zhang-haitao-repo/HoloCubic_Test/Doc/NaivePCB及外壳资料/NaivePCB及外壳资料/主板/主板v2.0（换卡槽版）/主板v2.0渲染图.png

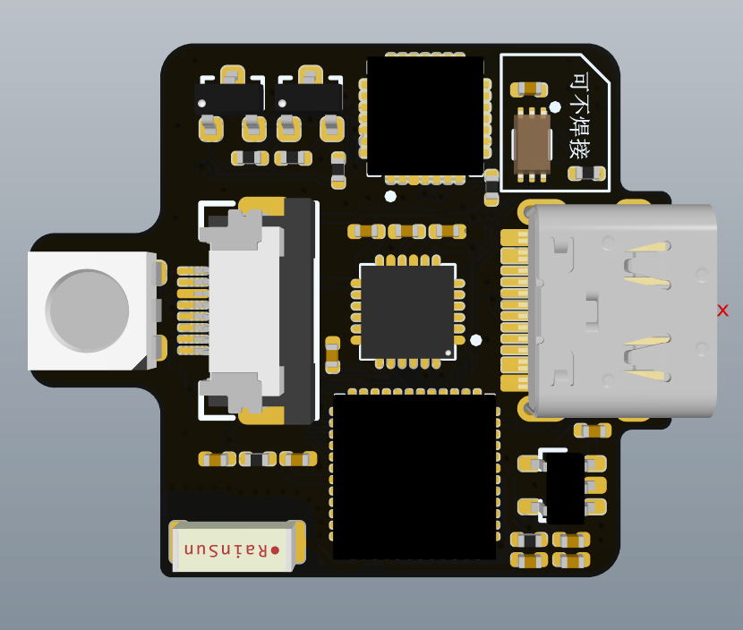
Doc/NaivePCB及外壳资料/NaivePCB及外壳资料/主板/主板v2.0（换卡槽版）/主板v2.0渲染图.png
