zhang-haitao-repo/HoloCubic_Test/Doc/NaivePCB及外壳资料/NaivePCB及外壳资料/屏幕拓展板/Naive屏幕板v1.5/Naive屏幕板v1.5渲染图.png

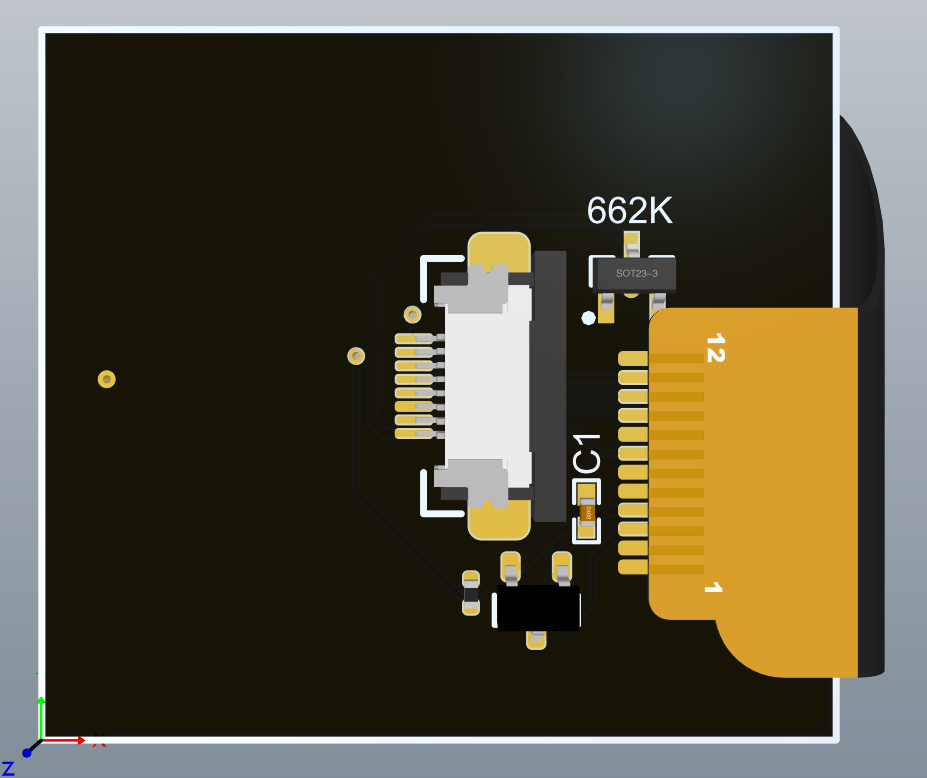
Doc/NaivePCB及外壳资料/NaivePCB及外壳资料/屏幕拓展板/Naive屏幕板v1.5/Naive屏幕板v1.5渲染图.png
