zhang-haitao-repo/HoloCubic_Test/Doc/【视频教程】小电视制作和使用.pdf

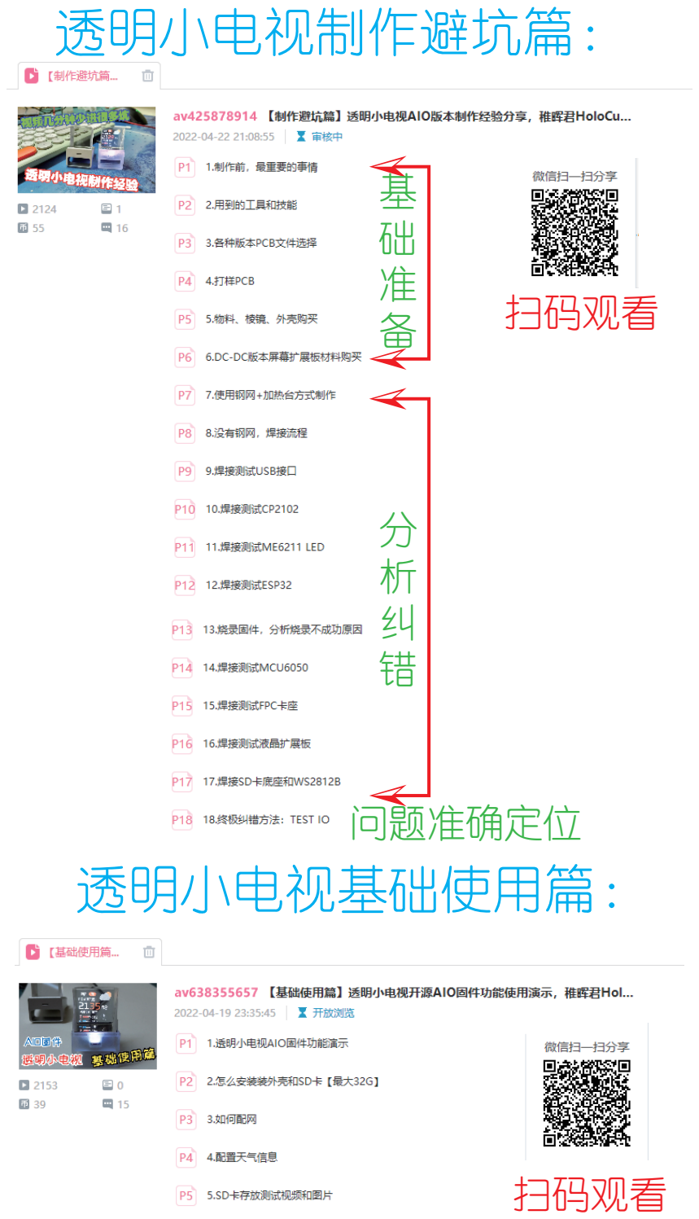
[picture p3: page 1]

透明小电视制作避坑篇：

透明小电视基础使用篇：

扫码观看

扫码观看

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
问题准确定位
