zhang-haitao-repo/HoloCubic_Test/Doc/NaivePCB及外壳资料/NaivePCB及外壳资料/3D文件/Naive磁吸底座（上部）.png

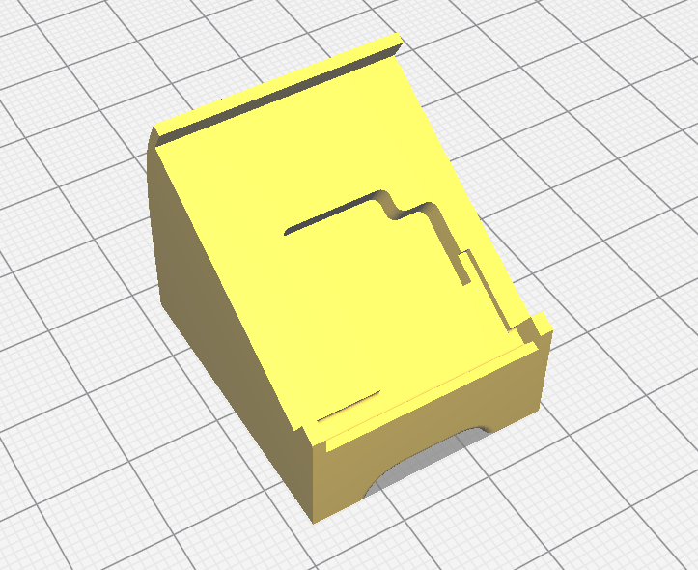
Doc/NaivePCB及外壳资料/NaivePCB及外壳资料/3D文件/Naive磁吸底座（上部）.png
