zhang-haitao-repo/HoloCubic_Test/Doc/NaivePCB及外壳资料/NaivePCB及外壳资料/3D文件/Naive磁吸底座（下部全封闭款）.jpg

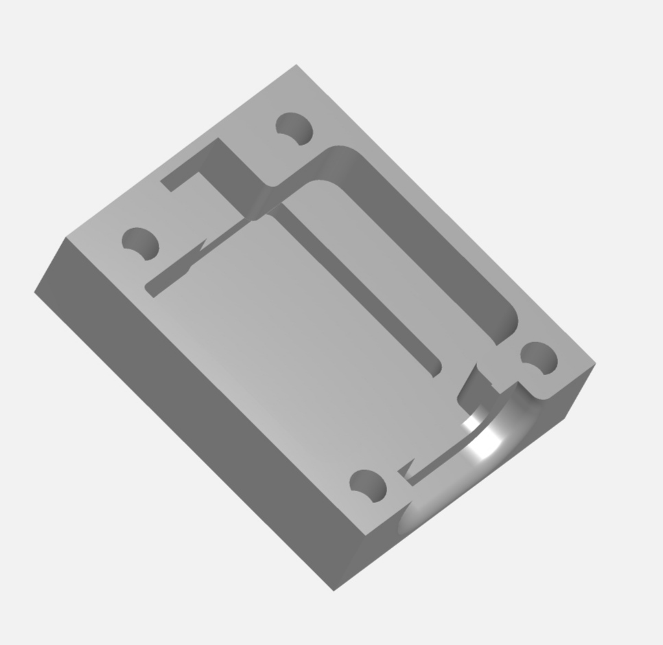
Doc/NaivePCB及外壳资料/NaivePCB及外壳资料/3D文件/Naive磁吸底座（下部全封闭款）.jpg
