zhang-haitao-repo/HoloCubic_Test/Doc/NaivePCB及外壳资料/NaivePCB及外壳资料/3D文件/高脚底部（下部）.jpg

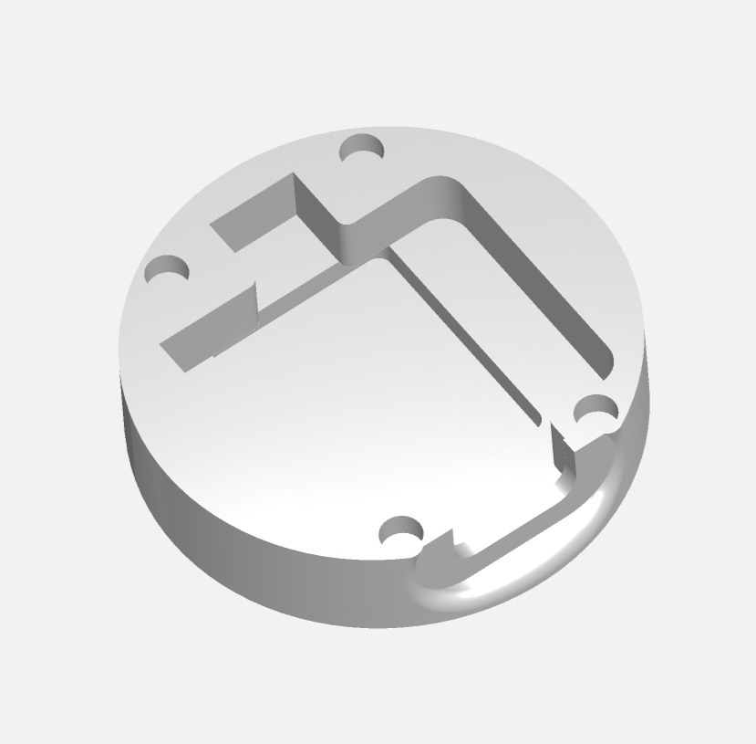
Doc/NaivePCB及外壳资料/NaivePCB及外壳资料/3D文件/高脚底部（下部）.jpg
