zhang-haitao-repo/HoloCubic_Test/Doc/NaivePCB及外壳资料/NaivePCB及外壳资料/Naive版本说明_必看.png

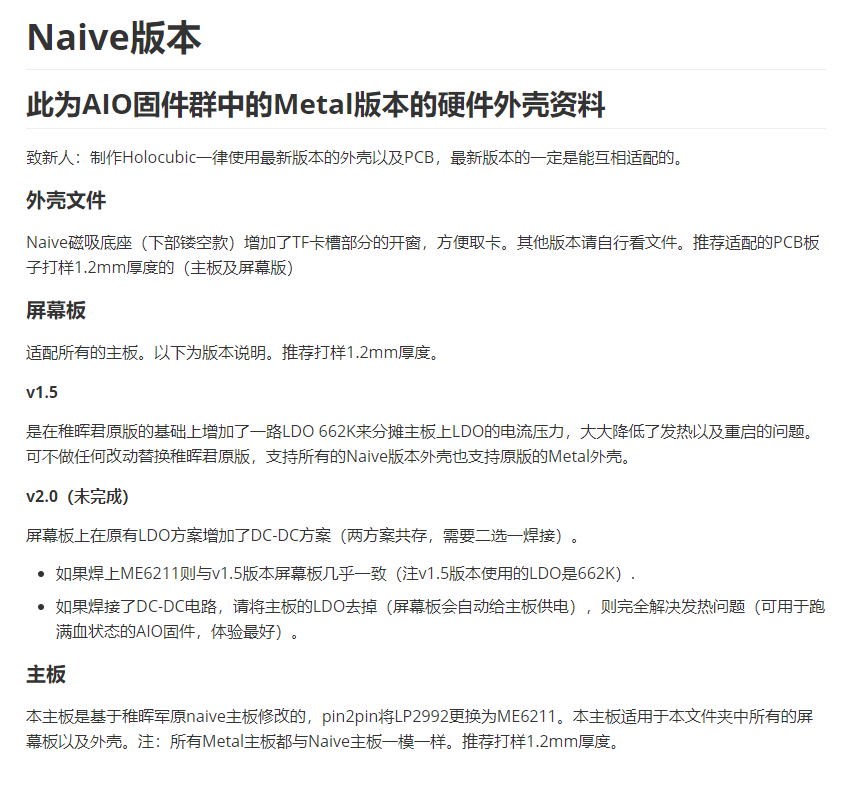
Doc/NaivePCB及外壳资料/NaivePCB及外壳资料/Naive版本说明_必看.png
