zhang-haitao-repo/HoloCubic_Test/Doc/Naive版材料购买清单（最新版）(1).xlsx

Comment | Description | Designator | Footprint | LibRef | Quantity | 商品链接 | 参考单价 | 备注
RAINSUN | 2.4G陶瓷天线 | A1 | ANT-Rainsun-AN5120 | ANT-Rainsun-AP5120 | 1 | 原装正品 AN2051-245 2.4G全向天线 RF射频蓝牙 陶瓷贴片WIFI内置 (https://item.taobao.com/item.htm?spm=2013.1.1997525049.8.78921d28ikxCBQ&id=558699169012) | 1.60 | 优信电子有邮费，凑单便宜
0.1uF | Capacitor | C1, C5, C7, C8, C10, C11 | CAP_0402 | 电容-0402 | 6 | 0402贴片电容 100NF (104K) 50V 精度±10% （100只） (https://item.taobao.com/item.htm?spm=a1z10.3-c-s.w4002-21223910208.30.2ef96a4brsMrER&id=523808399191)
10uF | Capacitor | C2, C4 | CAP_0402 | 电容-0402 | 2 | 0402贴片电容 10UF (106K) 10V 精度±10% （100只） (https://item.taobao.com/item.htm?spm=a1z10.3-c-s.w4002-21223910208.44.41706a4bzsA4e1&id=523808259470)
10nF | Capacitor | C3, C6 | CAP_0402 | 电容-0402 | 2 | 0402贴片电容 10NF (103K) 50V 精度±10% （100只） (https://item.taobao.com/item.htm?spm=a1z10.3-c-s.w4002-21223910208.22.12a16a4b9latJZ&id=523840872484)
2.2nF | Capacitor | C9 | CAP_0402 | 电容-0402 | 1 | 0402贴片电容 2.2nF(222) ±10% 50V X7R 0402B222K500NT (100只) (https://item.taobao.com/item.htm?spm=a1z10.3-c-s.w4002-21223910208.16.fcd26a4bw1pqA4&id=560753824095)
FFC_0.5_8 | FFC排线插座 翻盖下接 | CON1 | FFC_0.5_8 | FFC_0.5_8 | 1 | FFC/FPC连接器0.5MM 上接 下接 翻盖下接 4/6/8/10/12/14/16—40P-淘宝网 (taobao.com) (https://item.taobao.com/item.htm?spm=a1z0d.7625083.1998302264.6.5c5f4e69z3WtU1&id=552629356951) | 0.24 | 优信电子单买有邮费，凑单包邮
RGB | LED | D1 | LED_5050_WS2812B | LED_5050_WS2812B | 1 | 灯带用5050RGB幻彩WS2812B四脚内置IC灯珠6812可编程LED发光管 (https://detail.tmall.com/item.htm?id=580292748208) | 0.19 | 邮费3块
TF-Socket | Amphenol 1140084168 | J1 | TF-Card-Amphenol with TF | TF-Socket | 1 | DM3D-SF 原装卡座-淘宝网 (taobao.com) (https://item.taobao.com/item.htm?spm=a1z09.2.0.0.1eb92e8dvqWwZX&id=539108142338&_u=826i0hiu7415) | 7.00 | 这是稚晖君旧版卡槽，换卡槽转向下看
10K | Resistor | R1, R6, R7, R8, R9, R10, R11 | RES_0402 | 电阻-0402 | 7 | 【优信电子】0402贴片电阻 10K 10千欧 1/16W 精度±1% （50只） (https://item.taobao.com/item.htm?spm=a1z10.3-c-s.w4002-21223910208.9.630e6a4bKTOYhG&id=525633713781) |  | 可以优信采购，也可以嘉立创直接贴片
0R | Resistor | R2 | RES_0402 | 电阻-0402 | 1 | 0402贴片电阻 0欧 0R 1/16W 精度±5% （100只） (https://item.taobao.com/item.htm?spm=a1z10.3-c-s.w4002-21223910208.12.15e06a4bNtUrD1&id=523767583740)
200R | Resistor | R3 | RES_0402 | 电阻-0402 | 1 | 0402贴片电阻 200欧 200R 1/16W 精度±1% （50只） (https://item.taobao.com/item.htm?spm=a1z10.3-c-s.w4002-21223910208.54.35716a4bySZwWI&id=525601373139)
12K | Resistor | R4, R5 | RES_0402 | 电阻-0402 | 2 | 0402贴片电阻 12K 12千欧 1/16W 精度±1% （50只） (https://item.taobao.com/item.htm?spm=a1z10.3-c-s.w4002-21223910208.30.53f36a4bMj0cKA&id=525629142745)
CP2102 | USB转TTL | U1 | QFN-28 | CP2102 | 1 | 原装正品 贴片 28脚 CP2102 CP2102-GMR USB转UART 桥接控制器-淘宝网 (taobao.com) (https://item.taobao.com/item.htm?spm=a1z10.3-c-s.w4002-21223910208.9.10976a4b0vv4BF&id=522575454240) | 9.66
ME6211 | LDO | U2 | SOT23-5 | ME6211 | 1 | 原装正品 ME6211C33M5G-N SOT23-5 3.3V 500mA 低压差线性稳压器 (https://item.taobao.com/item.htm?id=572750408153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) | 0.39
MPU6050 | 六轴传感器 | U3 | QFN-24 | MPU6050 | 1 | 贴片 MPU-6050 芯片 陀螺仪/加速度计 6轴 可编程 I2C QFN-24 (https://item.taobao.com/item.htm?spm=a230r.1.14.16.312b340dPErzs6&id=522554835655&ns=1&abbucket=11) | 17.30 | 优信的6050被群主买涨价了，也可以买模块拆上面的mpu6050用 | MPU-6050模块 三轴加速度陀螺仪6DOF GY-521有代码原理图 镀金板 (https://m.tb.cn/h.fPOH8Wy?tk=bbSS2XkoG5J「MPU-6050模块%20三轴加速度陀螺仪6DOF%20GY-521有代码原理图%20镀金板」)
ESP32_SIP |  | U4 | QFN-48_7X7 | ESP32-PICO | 1 | 原装正品 ESP32-PICO-D4 QFN-48 双核Wi-Fi&蓝牙MCU无线收发芯片-淘宝网 (taobao.com) (https://item.taobao.com/item.htm?spm=a1z10.3-c-s.w4002-21223910208.16.76aa6a4bSV2m3i&id=635409903966) | 14.60
BH1750FVI-TR | 光强度传感器 | U5 | BH1750FVI | BH1750FVI-TR | 1 | 全新原装 BH1750FVI BH1750FVI-TR 芯片 贴片 WSOF6 环境光传感器-tmall.com天猫 (https://detail.tmall.com/item.htm?spm=a230r.1.14.49.b4a92b40fYBOsI&id=661451560891&ns=1&abbucket=1) | 3.50
Type-C | Type-C母座 | USB1 | Type-C-TOP | USB-Type-C-TOP | 1 | 贴片USB-3.1插座 Type-C母座 16P 高清传输接口 4固定插脚 双向-淘宝网 (taobao.com) (https://item.taobao.com/item.htm?spm=a1z10.3-c-s.w4002-21223910208.9.52ac6a4bJ0p8WW&id=573090887123) | 0.52
S8050 | Surface mount NPN transistor, package SOT-23 | VT1, VT2 | SMT_TRIODE_NPN | SMT_TRIODE_NPN | 2 | 原装正品 S8050 丝印J3Y SOT-23 NPN 25V/500mA 贴片三极管 20只-淘宝网 (taobao.com) (https://item.taobao.com/item.htm?spm=a1z10.3-c-s.w4002-21223910208.9.75b56a4bJz5RG4&id=578924054863) | 0.10
Comment | Description | Designator | Footprint | LibRef | Quantity | 商品链接 | 参考单价
LCD-240x240 | 焊接式12Pin裸屏 （玻璃品牌随意） | 1 | LCD-240x240-NoHole | LCD-240x240 | 1 | 1.33寸ips 1.3寸TFT显示屏ips液晶1.3寸st7789 ips显示屏240x240 (https://item.taobao.com/item.htm?id=565306950948) | 14.00 | 推荐瀚彩
FFC_0.5_8 下接 | FFC座 | CON1 | FFC_0.5_8 | FFC_0.5_8 | 1 | FFC/FPC连接器0.5MM 上接 下接 翻盖下接 4/6/8/10/12/14/16—40P-淘宝网 (taobao.com) (https://item.taobao.com/item.htm?spm=a1z0d.7625083.1998302264.6.5c5f4e69z3WtU1&id=552629356951) | 0.24 | 上下接区别不大 | 推荐翻盖的，不然主板的ffc座后面的电容会挡住
AO3415A | MOSFET | Q1 | SOT23-3 | AO3415A | 1 | 全新原装UMW AO3415A SOT-23 -20V/-4A P沟道 MOS(场效应管)芯片-淘宝网 (taobao.com) (https://item.taobao.com/item.htm?spm=a1z10.3-c-s.w4002-21223910208.9.75556a4boEZKVt&id=653689578492) | 0.35
104 | 无极性贴片电容 | C1 | C 0402_M | C | 1 | 0402贴片电容 100NF (104K) 50V 精度±10% （100只）-淘宝网 (taobao.com) (https://item.taobao.com/item.htm?spm=a1z10.3-c-s.w4002-21223910208.10.27e36a4bo54evr&id=523808399191) | 0.01
XC6206P332MR | 低压差线性稳压芯片 | V1 | SOT23-3L | XC6206P332MR | 1 | 贴片 SOT-23 XC6206P332MR (662K) 3.3V 300MA 稳压芯片（20只）-淘宝网 (taobao.com) (https://item.taobao.com/item.htm?spm=a1z10.3-c-s.w4002-21223910208.9.76146a4bCiaSiQ&id=522573858401) | 0.10
1K | Resistor | R1 | RES_0402 | 电阻-0402 | 1 | 0402贴片电阻 1K 1千欧 1/16W 精度±1% （50只）-淘宝网 (taobao.com) (https://item.taobao.com/item.htm?spm=a1z10.3-c-s.w4002-21223910208.9.4fb76a4bQKVo38&id=525568795296) | 0.01
Comment | Description | Designator | Footprint | LibRef | Quantity | 商品链接 | 参考单价
分光棱镜 | 25.4mm 1:1 分光棱镜 |  |  |  | 1 | 稚晖君同款 分光棱镜25.4mm半透半反 HoloCubic光学影像分光投射-淘宝网 (taobao.com) (https://item.taobao.com/item.htm?spm=a1z0d.6639537.1997196601.41.43ad74842oraKq&id=659651321828) | 86.40 | 群友有优惠价，报aio固件群就行
FFC_0.5_8 | 8p同向0.5mm间距6cm排线 | CON1 | FFC_0.5_8 | FFC_0.5_8 | 1 | FFC/FPC软排线 液晶连接线 8P 同向/反向 0.5/1.0mm间距-淘宝网 (taobao.com) (https://item.taobao.com/item.htm?spm=a1z0d.7625083.1998302264.6.5c5f4e69k0kP9Y&id=549590794021) | 0.14 | 优信电子有邮费，凑单便宜 | 如果你的和拓展版用的FFC底座主板都是下接或者都是上接，就买同向，否则买反向，买最短的就足够了
推荐ffc排线以3cm为最佳，建议群友自行寻找
 |  |  |  |  |  | 以上所有商品链接未经打样测试，不能保证无误。
换卡槽版的材料补充
新版卡槽 | 翻盖内焊式 | SD/MINI/TF/MICRO卡座卡槽卡托卡套 大小/长短体带自弹式翻盖贴片 (https://detail.tmall.com/item.htm?id=622308751712&spm=a1z09.2.0.0.7de22e8dkxy4c9&_u=l35psh8uada5) |  |  |  | 卡槽用翻盖内焊式
磁吸充电线 | 可买可不买，拼多多有很多这种的，大概10块钱以内，淘宝也可以购买，我只买过拼多多的 | 磁吸充电线 (https://mobile.yangkeduo.com/goods1.html?goods_id=202879379885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) |  | 适用naïve版
焊接工具推荐
拆焊台 | 400w加八件 | led灯珠拆焊台发热板预热台液晶灯条拆焊bga芯片维修恒温加热贴片 (https://detail.tmall.com/item.htm?id=591896261597&spm=a1z09.2.0.0.69582e8d2NZBDk&_u=l35psh8udc61) |  |  |  |  | 21.8
烙铁，最好有一个刀头烙铁，拼多多20多块，就不放链接了
资金富裕的可以入一个风枪，因为没有买过，所以不做推荐
焊锡膏在淘宝买，30g就够了
另外ME6211可以换成RT9013或者XC6210
RT9013 | 原装正品 SOT23-5 RT9013-33GB 稳压器LDO 3.3V/500mA输出 (https://item.taobao.com/item.htm?spm=a1z10.3-c-s.w4002-21223910208.9.323f6a4bmCVL33&id=546701607083) |  |  | 0.66
XC6210 | 如果准备在立创商城配元器件可以购买 |  |  | 1
