zhang-haitao-repo/HoloCubic_Test/Doc/NaivePCB及外壳资料/NaivePCB及外壳资料/主板/主板v2.0（换卡槽版）/主板v2.0_BOM表单.xlsx

Comment | Description | Designator | Footprint | LibRef | Quantity
AN2051 |  | A1 | ANT-Rainsun-AN5120 | ANT-Rainsun-AP5120 | 1
0.1uF | Capacitor | C1, C5, C8, C10, C11 | CAP_0402 | 电容-0402 | 5
10uF | Capacitor | C2, C4, C7 | CAP_0402 | 电容-0402 | 3
10nF | Capacitor | C3, C6 | CAP_0402 | 电容-0402 | 2
2.2nF | Capacitor | C9 | CAP_0402 | 电容-0402 | 1
FFC_0.5_8 | FFC下接 | CON1 | FFC_0.5_8 | FFC_0.5_8 | 1
WS2812B |  | D1 | LED_5050_WS2812B |  | 1
TF-Socket | 翻盖式 | J1 | TF_F | TF-Socket | 1
10K | Resistor | R1, R6, R7, R8, R9, R10, R11_1_1 | RES_0402 | 电阻-0402 | 7
0R | Resistor | R2 | RES_0402 | 电阻-0402 | 1
200R | Resistor | R3 | RES_0402 | 电阻-0402 | 1
12K | Resistor | R4, R5 | RES_0402 | 电阻-0402 | 2
CP2102 | USB转TTL | U1 | QFN-28 | CP2102 | 1
ME6211C33 3V3 | LDO | U2 | SOT23-5 | LP2992 | 1
MPU6050 | 六轴传感器 | U3 | QFN-24 | MPU6050 | 1
ESP32_SIP |  | U4 | QFN-48_7X7 | ESP32-PICO | 1
BH1750FVI-TR |  | U5 | BH1750FVI | BH1750FVI-TR | 1
Type-C 16P |  | USB1 | Type-C-TOP | USB-Type-C-TOP | 1
S8050 | Surface mount NPN transistor, package SOT-23 | VT1, VT2 | SMT_TRIODE_NPN | SMT_TRIODE_NPN | 2
