zhang-haitao-repo/HoloCubic_Test/Doc/NaivePCB及外壳资料/NaivePCB及外壳资料/屏幕拓展板/Naive屏幕板v1.5/Naive_v1.5屏幕版BOM表.xlsx

Comment | Description | Designator | Footprint | LibRef | Quantity
LCD-240x240 | 显示屏 | 1 | LCD-240x240-NoHole | LCD-240x240 | 1
104 | 无极性贴片电容 | C1 | C 0402_M | C | 1
FFC_0.5_8 | FFC | CON1 | FFC_0.5_8 | FFC_0.5_8 | 1
AO3415A | MOSFET | Q1 | SOT23-3 | AO3415A | 1
1K | Resistor | R1 | RES_0402 | 电阻-0402 | 1
XC6206P332MR | 低压差线性稳压芯片 | V1 | SOT23-3L | XC6206P332MR | 1
