zhang-haitao-repo/HoloCubic_Test/Doc/NaivePCB及外壳资料/NaivePCB及外壳资料/3D文件/Naive磁吸底座（上部）.stp

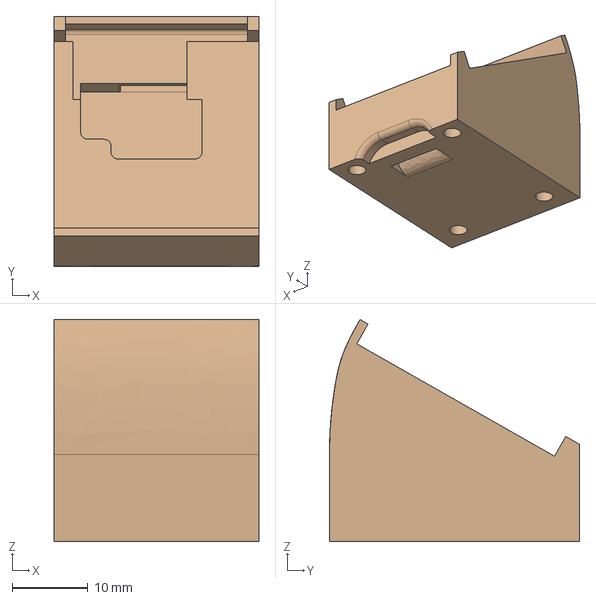
[picture p10: CAD file, 2022-05-05]
Doc/NaivePCB及外壳资料/NaivePCB及外壳资料/3D文件/Naive磁吸底座（上部）.stp
27.0 x 33.0 x 29.3 mm
