zhang-haitao-repo/HoloCubic_Test/Doc/NaivePCB及外壳资料/NaivePCB及外壳资料/3D文件/Naive磁吸底座（下部全封闭款）.stp

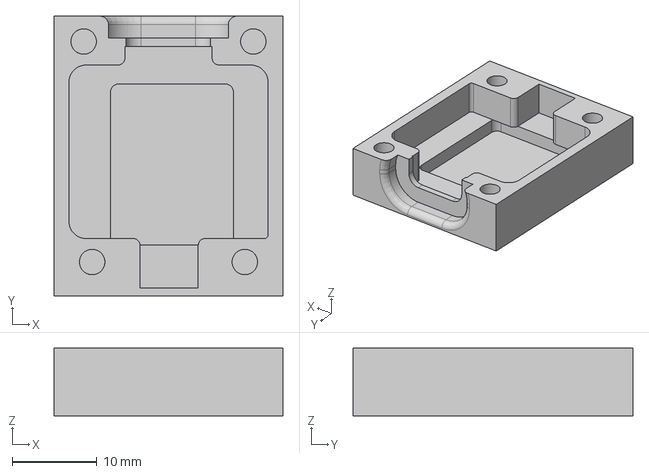
[picture p11: CAD file, 2022-05-05]
Doc/NaivePCB及外壳资料/NaivePCB及外壳资料/3D文件/Naive磁吸底座（下部全封闭款）.stp
27.0 x 33.0 x 8.00 mm
