zhang-haitao-repo/HoloCubic_Test/Doc/NaivePCB及外壳资料/NaivePCB及外壳资料/3D文件/Naive磁吸底座（下部镂空款）.stl

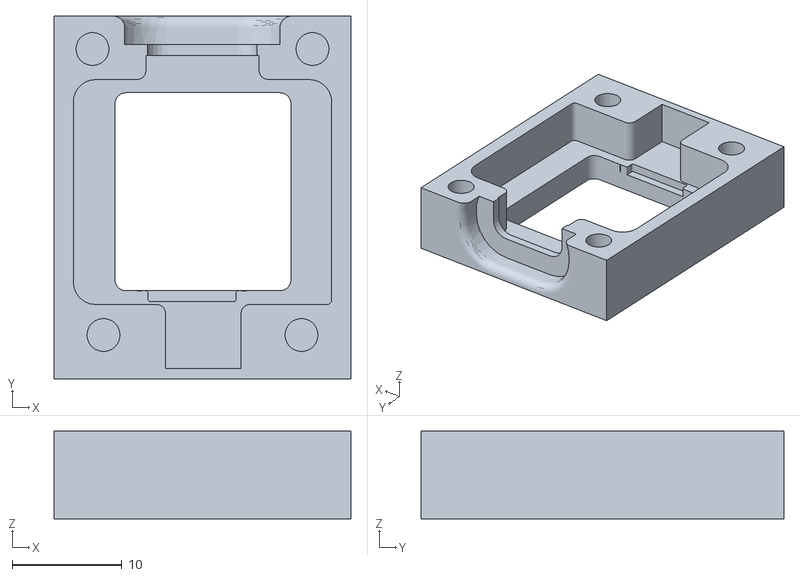
[picture p12: CAD file, 2022-05-05]
Doc/NaivePCB及外壳资料/NaivePCB及外壳资料/3D文件/Naive磁吸底座（下部镂空款）.stl
27.0 x 33.0 x 8.00
