zhang-haitao-repo/HoloCubic_Test/Doc/NaivePCB及外壳资料/NaivePCB及外壳资料/3D文件/高脚底座（上部）.stp

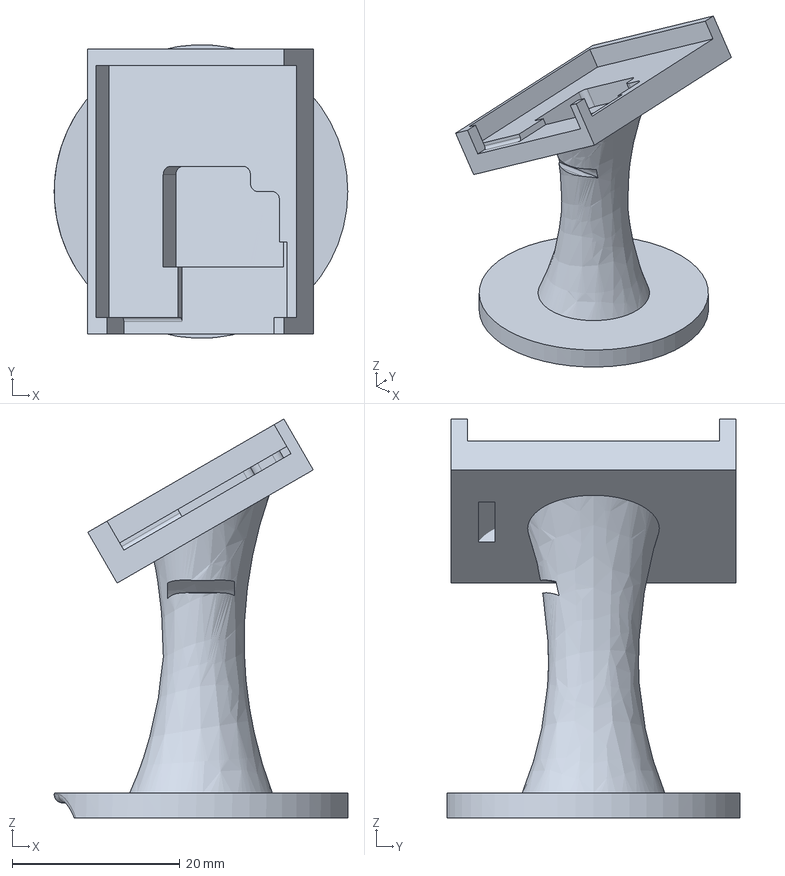
[picture p13: CAD file, 2022-05-05]
Doc/NaivePCB及外壳资料/NaivePCB及外壳资料/3D文件/高脚底座（上部）.stp
35.0 x 35.0 x 47.6 mm
