zhang-haitao-repo/HoloCubic_Test/Doc/NaivePCB及外壳资料/NaivePCB及外壳资料/3D文件/高脚底部（下部）.stp

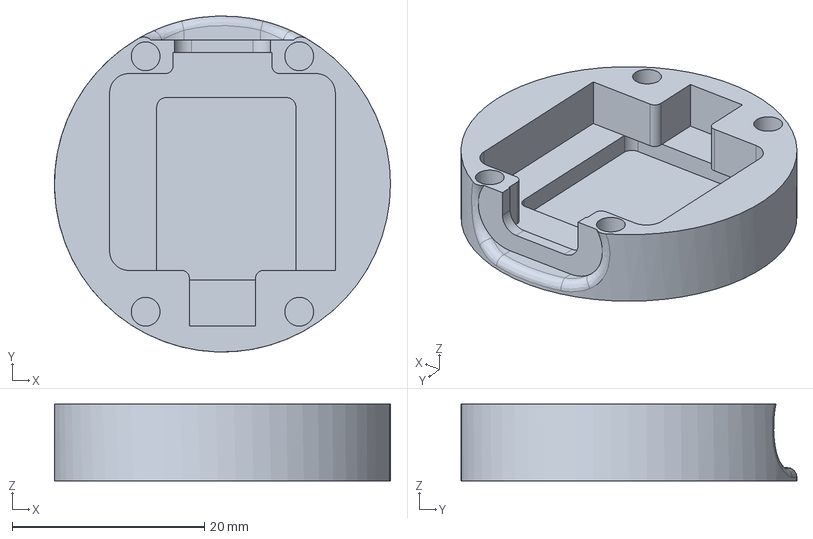
[picture p14: CAD file, 2022-05-05]
Doc/NaivePCB及外壳资料/NaivePCB及外壳资料/3D文件/高脚底部（下部）.stp
35.0 x 35.0 x 8.00 mm
