zhang-haitao-repo/HoloCubic_Test/Doc/NaivePCB及外壳资料/NaivePCB及外壳资料/主板/主板v2.0（换卡槽版）/工程预览图.pdf

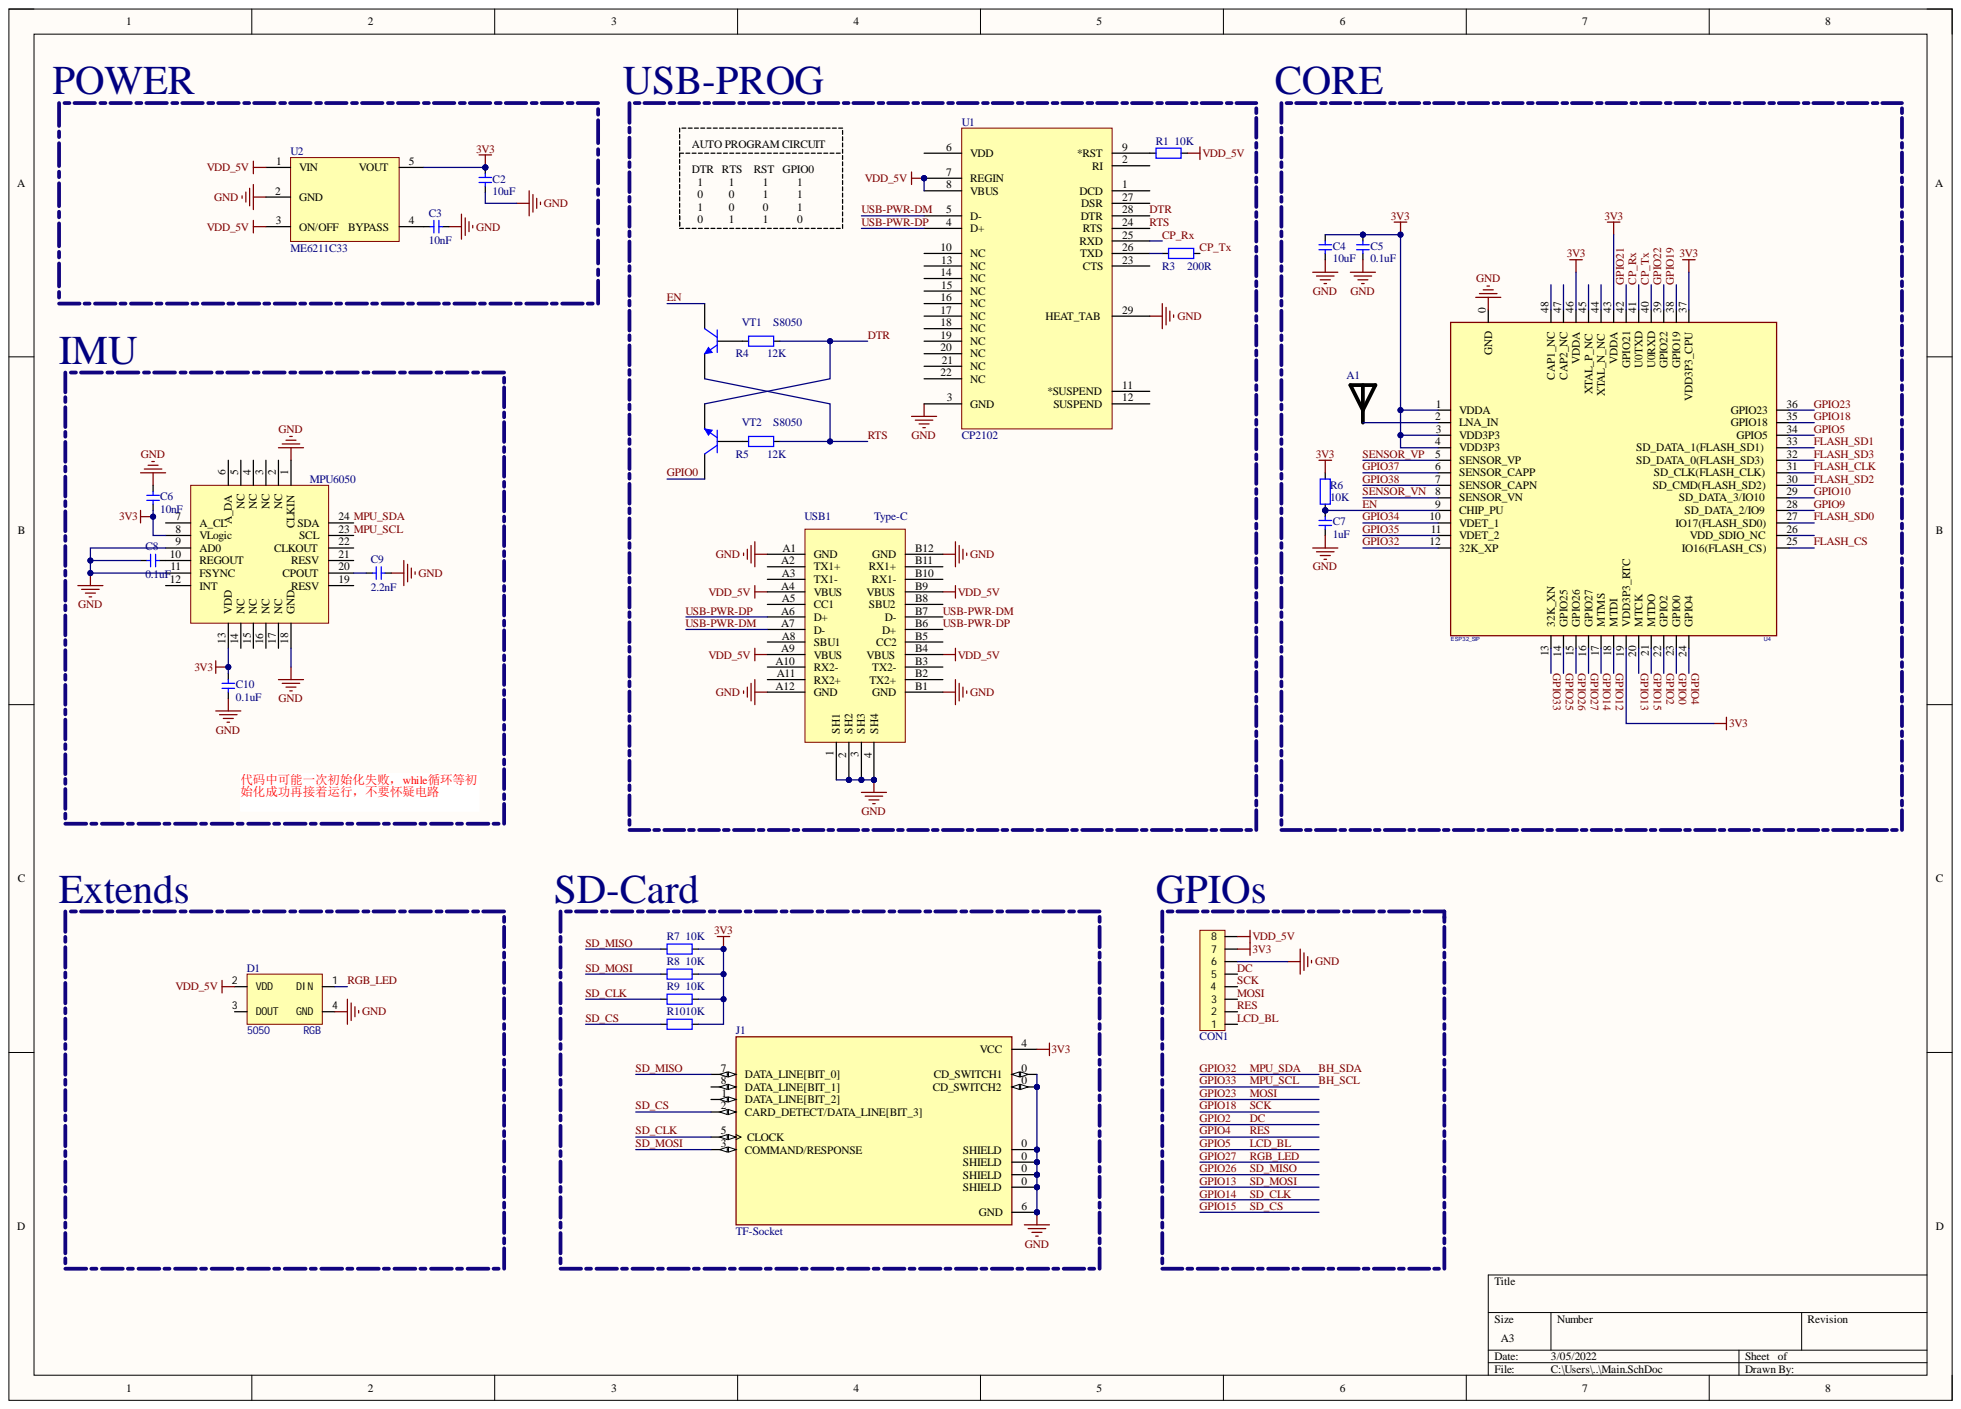
[picture p19: page 1]

CLKIN 1 NC 2 NC 3 NC 4 NC 5 A_DA 6

GND 18 RESV 19 CPOUT 20 RESV 21 CLKOUT 22 SCL 23 SDA 24

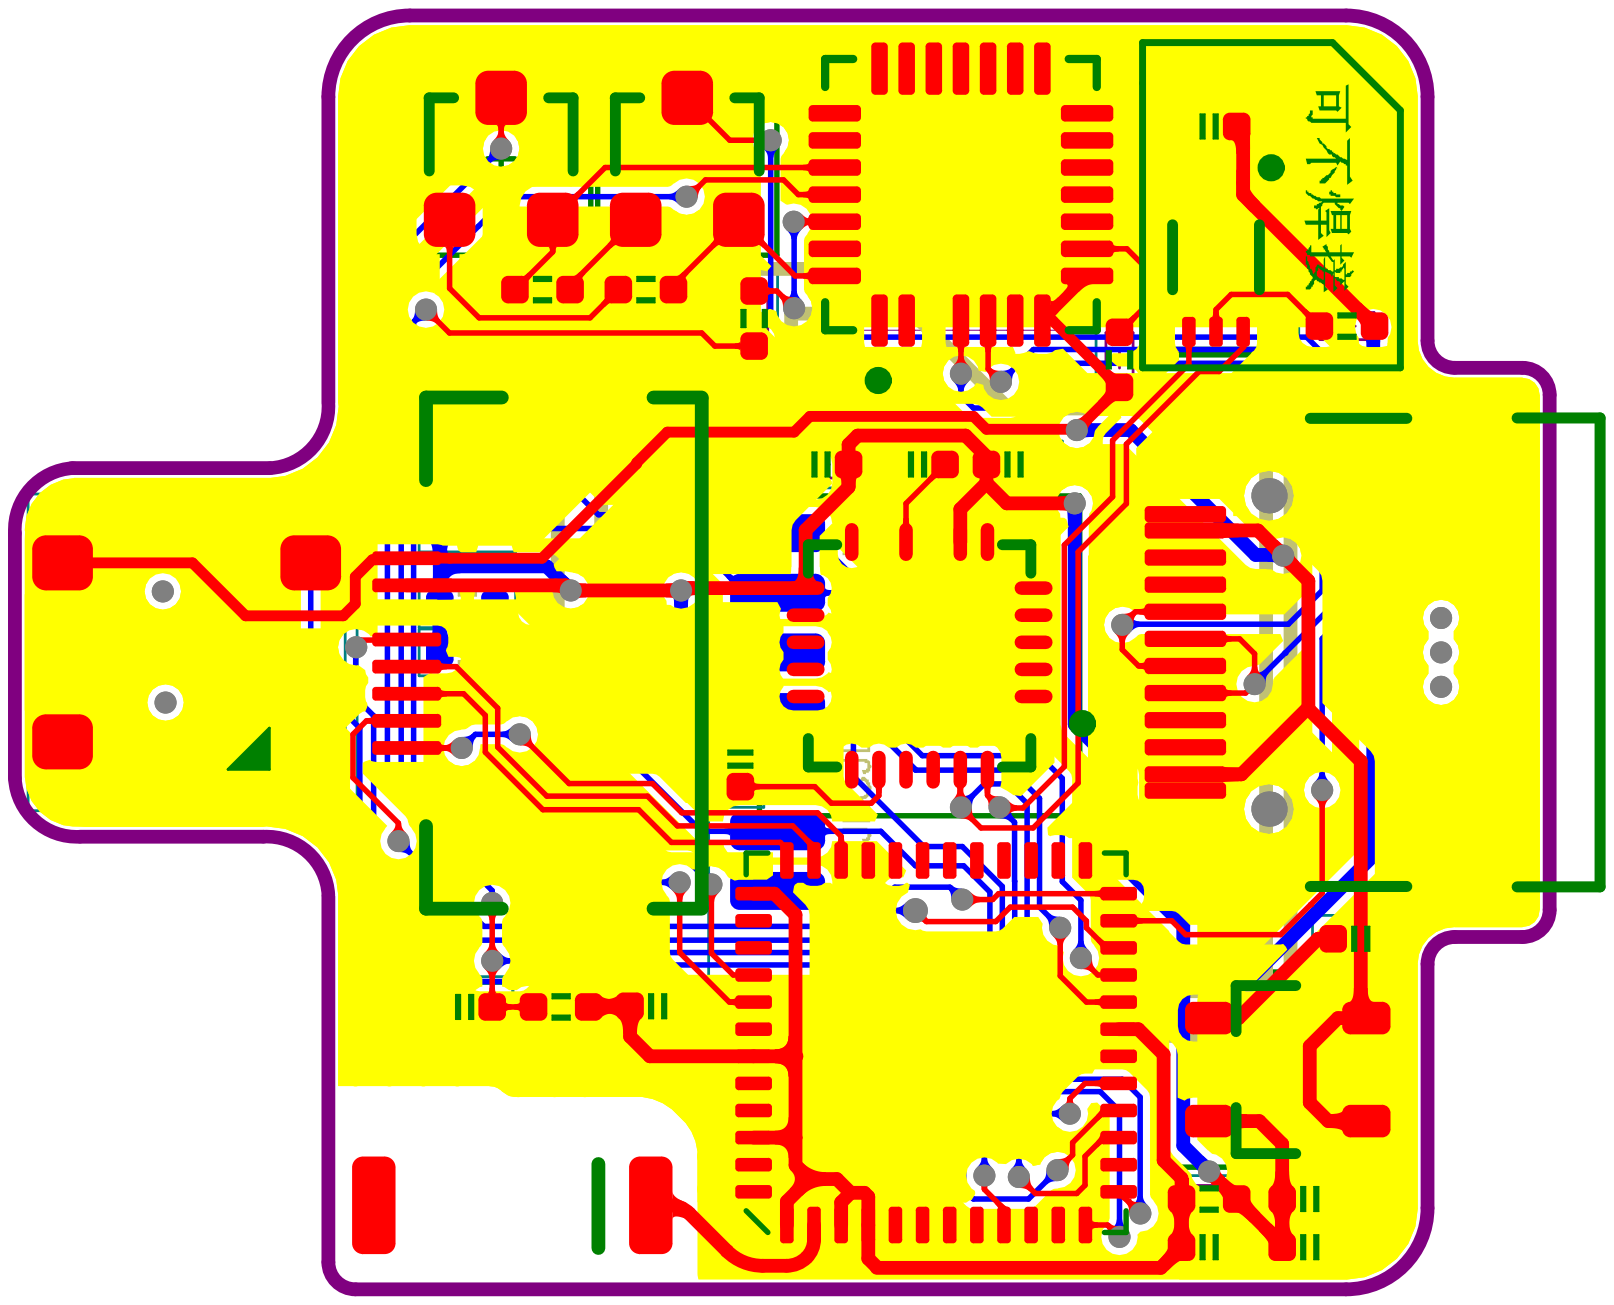
[picture p20: page 2]
