zhang-haitao-repo/HoloCubic_Test/Doc/NaivePCB及外壳资料/NaivePCB及外壳资料/屏幕拓展板/Naive屏幕板v1.5/工程预览图v1.5.pdf

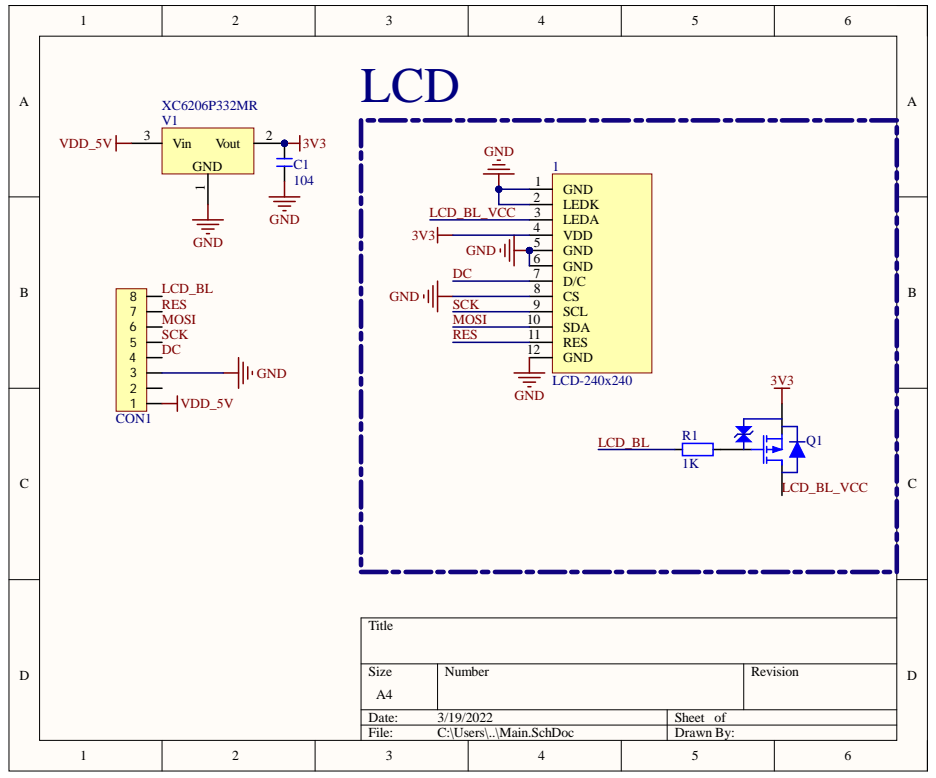
[picture p21: page 1]

Size A4 | Number | Revision

Date: 3/19/2022 | Sheet of
File: C:\Users\..\Main.SchDoc | Drawn By:

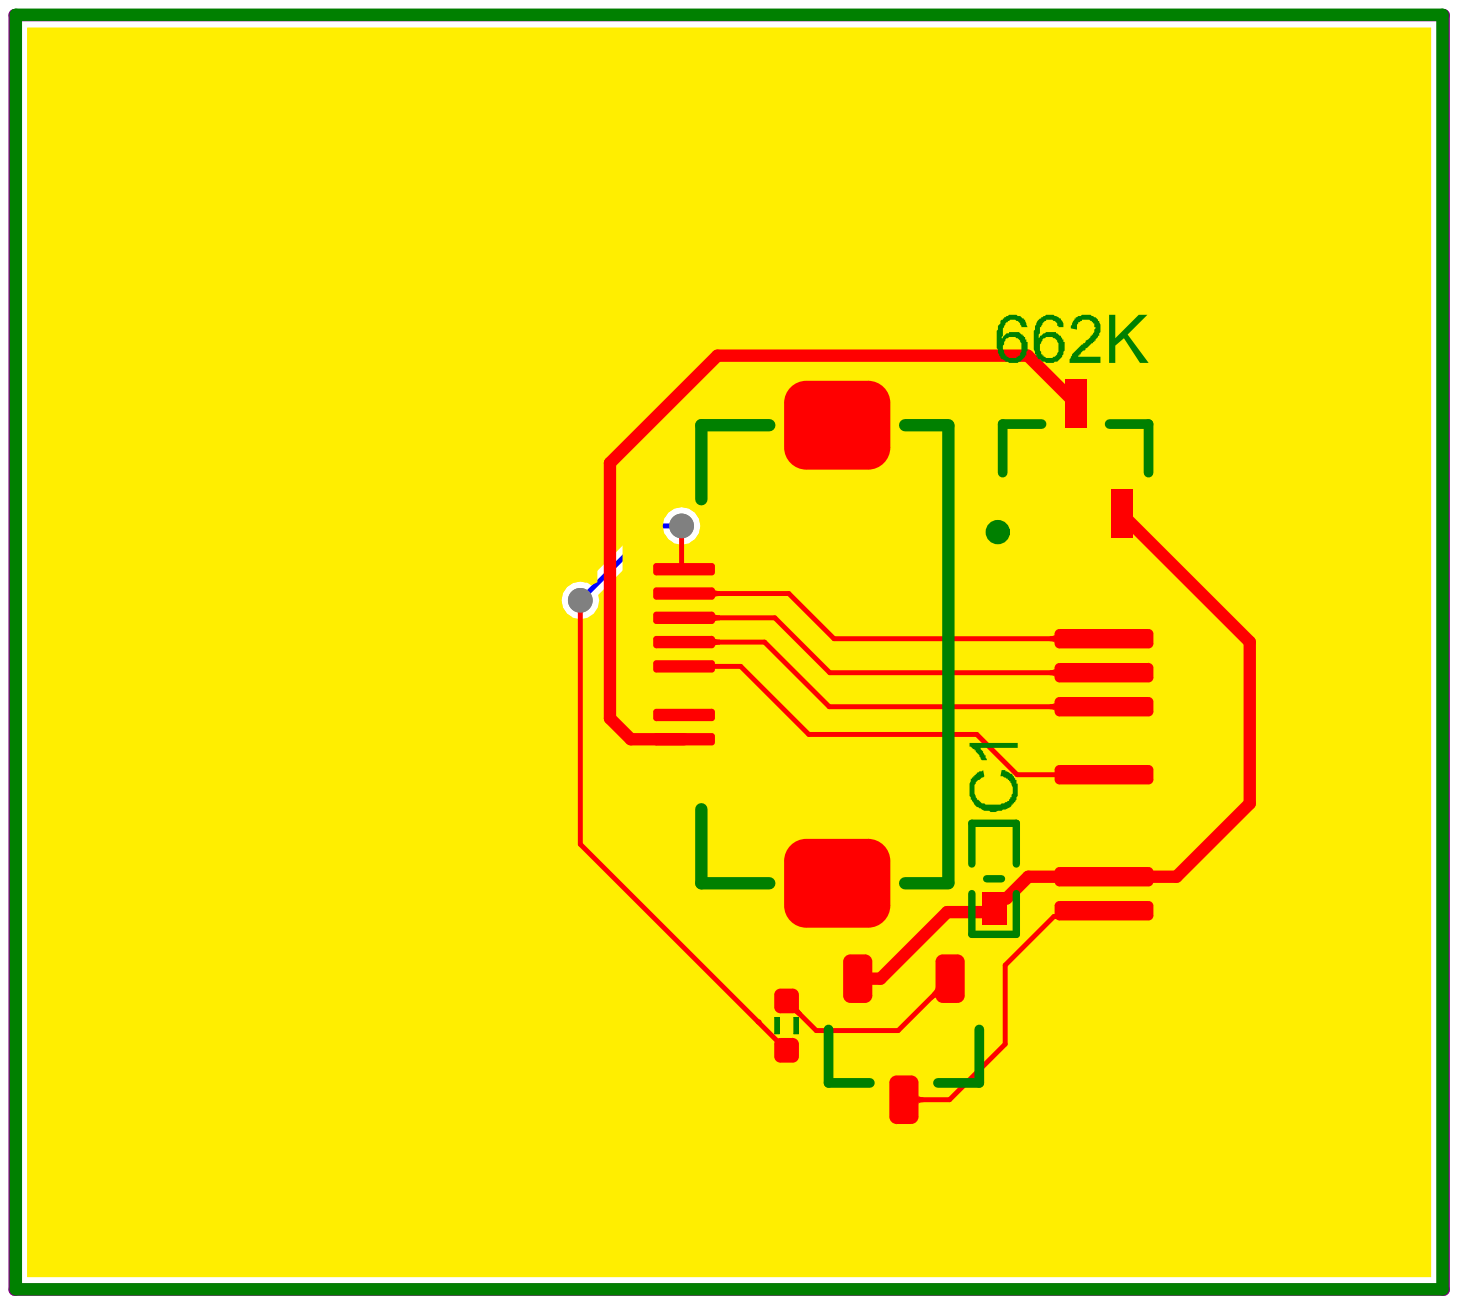
[picture p22: page 2]
