zhang-haitao-repo/HoloCubic_Test/(list of files, drawings)

Other design files:
Doc/NaivePCB及外壳资料/NaivePCB及外壳资料/主板/主板v1.3/Main.SchDoc
Doc/NaivePCB及外壳资料/NaivePCB及外壳资料/主板/主板v1.3/MainBoard.PrjPCB
Doc/NaivePCB及外壳资料/NaivePCB及外壳资料/主板/主板v1.3/MainBoardV1.3.PcbDoc
Doc/NaivePCB及外壳资料/NaivePCB及外壳资料/主板/主板v2.0（换卡槽版）/Main.SchDoc
Doc/NaivePCB及外壳资料/NaivePCB及外壳资料/主板/主板v2.0（换卡槽版）/MainBoard.PcbDoc
Doc/NaivePCB及外壳资料/NaivePCB及外壳资料/主板/主板v2.0（换卡槽版）/MainBoard.PrjPCB
Doc/NaivePCB及外壳资料/NaivePCB及外壳资料/屏幕拓展板/Naive屏幕板v1.5/ExtendBoard.PcbDoc
Doc/NaivePCB及外壳资料/NaivePCB及外壳资料/屏幕拓展板/Naive屏幕板v1.5/ExtendBoard.PcbLib
Doc/NaivePCB及外壳资料/NaivePCB及外壳资料/屏幕拓展板/Naive屏幕板v1.5/ExtendBoard.PrjPCB
Doc/NaivePCB及外壳资料/NaivePCB及外壳资料/屏幕拓展板/Naive屏幕板v1.5/ExtendBoard_1.SCHLIB
Doc/NaivePCB及外壳资料/NaivePCB及外壳资料/屏幕拓展板/Naive屏幕板v1.5/Main.SchDoc
Doc/NaivePCB及外壳资料/NaivePCB及外壳资料/屏幕拓展板/Naive屏幕板v2.0（未完成）/ExtendBoard.PcbLib
Doc/NaivePCB及外壳资料/NaivePCB及外壳资料/屏幕拓展板/Naive屏幕板v2.0（未完成）/ExtendBoard.PrjPCB
Doc/NaivePCB及外壳资料/NaivePCB及外壳资料/屏幕拓展板/Naive屏幕板v2.0（未完成）/ExtendBoard.SCHLIB
Doc/NaivePCB及外壳资料/NaivePCB及外壳资料/屏幕拓展板/Naive屏幕板v2.0（未完成）/Main.SchDoc
Doc/NaivePCB及外壳资料/NaivePCB及外壳资料/屏幕拓展板/Naive屏幕板v2.0（未完成）/Naive扩展板.PcbDoc
